ThePandoConnection/CANAuth/WhatsApp Image 2024-05-06 at 14.47.56_473a129f.jpg

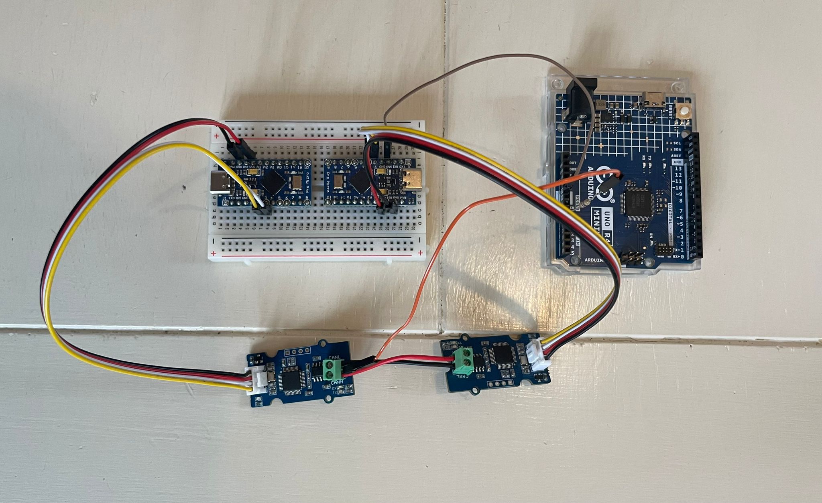
WhatsApp Image 2024-05-06 at 14.47.56_473a129f.jpg
