ThePandoConnection/CANAuth/WhatsApp Image 2024-05-06 at 14.50.31_afb78850.jpg

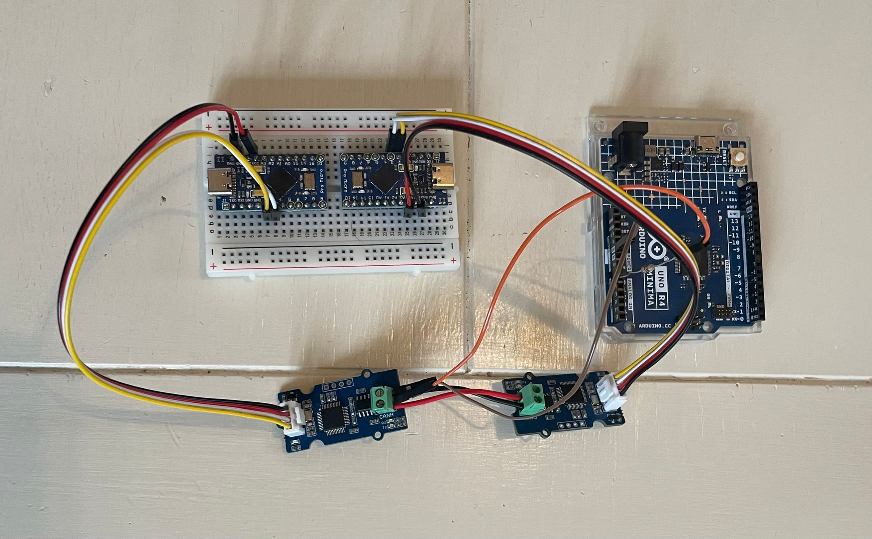
WhatsApp Image 2024-05-06 at 14.50.31_afb78850.jpg
