ThePandoConnection/CANAuth/README.md

# CANAuth
A CAN bus authentication system to differentiate nodes by signal strength.

Includes:
- Arduino code
- Main control Python script
- Datasets used in the paper
- Results used to create model
- Results from final prototype
- Images of each physical deliverable

The library for the arduino code can be found at:
https://docs.longan-labs.cc/114992978/#test-the-board

The CAN receive and send code is heavily based on the examples from this library as stated in the paper.
