ThePandoConnection/CANAuth/(commit log)

2024-03-27 set up both threads, I think i will share data with a txt or csv but i need to make sure its thread safe.
2024-04-15 attempting to start recording voltage when ID detected.
2024-04-15 added a requirments.txt, looks like coordination code is set up, no testing done yet. just need to figure out third thread for comparing voltage and ID
2024-04-23 adapted ID detection to work with arduino, next step is testing results.
2024-04-25 adjusted voltage reading code.
2024-04-25 added guess length to voltage code. equation fits perfectly so hopefully the rest of the code works. Will test everything properly when I have time.
2024-04-25 message code tested and seems to be working. will move over to the voltage code soon.
2024-04-27 Got voltage code fully ready for testing.
2024-04-27 first value works, so far got 60 and 33 which is within rounding error!!
    [main.py]
2024-04-27 code now functioning mostly, need to test values to get the length. Completely rewritten but legacy thread stuff needs removed.
2024-04-29 removed all the old multi threading code. still trying to figure out correct equation.
    [main.py]
2024-05-03 Commented and implemented error checking. Error checking is specific to the experiment so would need to be adapted for real use.
    [main.py]
2024-05-03 changed error check to be more readable and a bit more fault-tolerant.
    [main.py]
2024-05-03 added datasets and Arduino Code
    [100mmHigh.csv, 150mmHigh.csv, 200mmHigh.csv, 50mmHigh.csv, CAN High Change Resistors.xlsx]
2024-05-06 added more data and changed readme
    [Across CAN Voltage comparison.xlsx]
2024-05-09 organised data
    [100mmHigh.csv, 150mmHigh.csv, 200mmHigh.csv, 50mmHigh.csv, Across CAN Low.xlsx, Across CAN Voltage comparison.xlsx, CAN High Change Resistors.xlsx]
